MarkShiro/RoboDog-Zero/firmware/README.md

# Загрузка Arduino: пульт Pro Mini и Mega 2560

Все `.ino` открываются из одноимённой папки целиком: соседние `.h/.cpp` входят в сборку. Выберите **Arduino Pro or Pro Mini → ATmega328P (3.3V, 8 MHz)** для пульта и **Arduino Mega or Mega 2560 → ATmega2560** для робота. Проверенные зависимости: Arduino AVR Boards 1.8.6; Adafruit GFX 1.11.11; Adafruit ST7735 and ST7789 1.11.0; Adafruit BusIO 1.16.1; TMCStepper 0.7.3; Adafruit NeoPixel 1.15.2.

## 1. Пульт: безопасный тест

Загрузите [`RoboDogRemoteTest/RoboDogRemoteTest.ino`](RoboDogRemoteTest/RoboDogRemoteTest.ino). Перед загрузкой снимите джампер X2, если HC-05 подключён к D0/D1 и мешает загрузчику. Скетч проверяет дисплей ST7735 1,77″, восемь кнопок, напряжение батареи самого пульта через A6 и счётчик входящих строк Bluetooth. **Он не передаёт движущих команд.**

Кнопки: D4 вперёд, D5 назад, D6 влево, D7 вправо, D12 меню, A0 вверх, A1 вниз, A2 подтверждение. Цвет соответствующей кнопки должен меняться при нажатии. Число `LOCAL` зависит от фактического делителя батареи пульта и VREF 3,3 В; проверьте мультиметром. Если экран пуст, сначала проверьте питание/подсветку и CS10/DC9/RESET2, затем тип вкладки ST7735 в `initR`.

## 2. Пульт: основная прошивка

Загрузите [`RoboDogRemoteFinal/RoboDogRemoteFinal.ino`](RoboDogRemoteFinal/RoboDogRemoteFinal.ino), верните джампер X2 после завершения прошивки. Экран показывает напряжение робота из телеметрии Mega и примерный процент 8S LiFePO4. Цвет: 0–29% красный, 30–59% жёлтый, 60–99% зелёный, 100% синий. Сейчас 0% привязан к 24,0 В, 100% к 26,6 В в `battery.h`: это **шкала напряжения**, не измерение оставшейся ёмкости. Под нагрузкой показание может проседать. Батарея самого пульта измеряется отдельно и не подменяет напряжение робота.

Прошивка посылает кадры `C` 20 раз/с через HC-05 38400 бод и ждёт телеметрию `T`. При открытом меню кнопки движения игнорируются. Долгое нажатие/пункт «лечь» и команда отключения двигателей действуют только на уже разрешённую Mega; пульт не выполняет ARM. Если связи нет, на дисплее нет достоверного процента робота. Нельзя обходить этот признак подстановкой постоянного числа.

## 3. Mega: отдельный тест карты моторов

Актуальный порядок — [общая пусконаладка](../docs/commissioning.md) и [проверка концевиков любого порядка и NO/NC](../docs/limit-switches.md). Датчики проверяйте командой `STATUS` **до** `SCAN`: строка `raw` показывает HIGH как 1, строка `pressed` использует настроенную полярность каждого физического входа.

Загрузите [`RoboDogMotorMap/RoboDogMotorMap.ino`](RoboDogMotorMap/RoboDogMotorMap.ino) и пройдите [порядок пусконаладки](../docs/commissioning.md). Монитор USB 115200, окончание строки `Newline`. Поддержите корпус и каждую ногу; сначала проверьте физическое отключение питания двигателей. Последовательность `SCAN` → `J1` → `ARM` → `J +50` двигает **один** канал не более чем на 50 микрошагов. `J -50` — обратное направление, `!` — немедленная остановка, `OFF` — выключение. `SCAN` должен увидеть все восемь TMC2209. После каждого jog нужно повторять `ARM`. Запишите измеренные канал/ногу/сустав/направление/концевик в [таблицу](../docs/orange-pi/Mega-calibration-worksheet.csv). Тестовые 600 мА RMS заданы через UART при внешнем Rsense 0,11 Ω и нужны только для поддержанных ног, не для удержания всей массы.

## 4. Mega: основная прошивка

Создавайте `calibration.h` из измеренного локального JSON с помощью [генератора](../tools/generate_calibration.py): он проверяет уникальность входов и суставов и позволяет сначала проверить логические состояния датчиков с заблокированным ARM. Действия `--unlock` и `--enable-trot` разделены.

Загрузите [`RoboDogMegaFinal/RoboDogMegaFinal.ino`](RoboDogMegaFinal/RoboDogMegaFinal.ino), затем следуйте её [подробной инструкции](RoboDogMegaFinal/README.md). В стандартной сборке поиск нуля идёт по **восьми концевикам**. Значения калибровки намеренно пустые, `ROBOT_CALIBRATED=false`, опытная рысь выключена. После заполнения J1–J8 и проверки пределов, питания, аппаратного аварийного разрыва и D41 разрешите измеренную конфигурацию. Команда `ARM HOME` требует непрерывного нейтрального управления от Orange Pi; открыть USB-монитор и написать её без канала пульта недостаточно. Временная стендовая конфигурация `ARM ZERO` без датчиков — отдельный переключатель в `calibration.h`, описанный в инструкции; для итогового комплекта оставить 0.

На всех этапах сверяйте физическую разводку с электросхемой конкретной сборки. Передаточное число в прошивке — **12:1**. Диапазон положения ноги 30–40° относительно горизонта не задаёт автоматически электрические пределы каждого двигателя.
