MarkShiro/RoboDog-Zero/firmware/RoboDogMegaFinal/README.md

# RoboDogMegaFinal — прошивка, калибруемая под каждый экземпляр

Плата: Arduino Mega 2560, ATmega2560, 16 МГц.

**Заводская конфигурация разрешает проверку запуска и связи, но блокирует движение.** Для комплекта с восемью концевиками используется `ROBODOG_STARTUP_ZERO_MODE=0`; команда `ARM HOME` запускает ограниченный поиск нулей после калибровки. Соответствие J1–J8, направления и положения датчиков измеряются на каждом экземпляре и заносятся в локальный профиль. Отдельный стендовый режим временного нуля без концевиков описан ниже.

Стендовый скетч [`RoboDogMotorMap`](../RoboDogMotorMap/) загружается отдельно; его файлы не смешивают с этой папкой.

## 1. Что реализовано

- Нет автоматического включения моторного питания и поиска нулей в `setup()`.
- После STOP, тайм-аута и ошибки нет автоматического повторного включения.
- Разрешение работы отдельной командой; требуются проверенная карта/знаки/пределы, свежий нейтральный поток управления, исправные напряжения, аппаратный разрыв силовой цепи и все восемь драйверов. Для режима с концевиками дополнительно требуется проверенный D41.
- Конфигурация TMC2209 через две UART-шины, внешние R110, 16 микрошагов, начальные 600 мА RMS, SpreadCycle. Проверяется связь и ряд регистров.
- Прекращение импульсов и снятие EN при зависании основного цикла примерно на 250 мс по таймеру; срок ограничен также остатком актуальности команды. Это программная защита, её реальные задержки нужно измерить.
- Независимый watchdog AVR на 4 с для перезапуска зависшей программы. Сброс Mega может снять самоудержание всего робота — это свойство схемы, а не штатное завершение Linux.
- Парсер с CRC, ограничением длины, строгими диапазонами и отбраковкой хвоста переполненной строки.
- Повторный/старый `seq` в пределах активного сеанса не продлевает время команды. Корректный STOP обрабатывается даже из старого пакета.
- В основной конфигурации выполняется ограниченный поиск нулей по концевикам. Для стендовых испытаний доступен отдельный режим временного нуля без движения.
- Программные пределы суставов после поиска нулей, включая запрет следующего импульса за границу в обработчике таймера. Потерянные шаги между повторными поисками нулей не обнаруживаются.
- Поза лёжа сохраняется после короткого сигнала пульта; нейтральное управление не заставляет автоматически вернуться в стойку.
- Экспериментальная диагональная походка отдельно заблокирована. Она задаёт синусоидальные углы суставов, не решает обратную кинематику стоп и не стабилизирует корпус.
- Телеметрия `T` совместима с подготовленным пультом.
- Дополнительный кадр `I,roll,pitch,temp,flags` с CRC передаёт углы MPU6050 для экрана Orange Pi примерно 5 раз/с. Углы вычисляются по акселерометру и при рывках ненадёжны.
- Кадр `K` игнорируется и не меняет время снятия питания. Автоматическое снятие самоудержания по умолчанию выключено до испытания завершения Orange Pi.

## 2. Какие файлы менять

| Файл | Назначение |
|---|---|
| `RoboDogMegaFinal.ino` | Главный цикл, состояния, команды USB, включение и отключение |
| `calibration.h` | Карта осей, углы, пределы и разрешающие проверки |
| `config.h` | Пины, напряжения, ток, тайм-ауты и частота шагового таймера |
| `steppers.cpp/.h` | TMC2209, STEP/DIR, контроль разрешения и границ |
| `motion.cpp/.h` | Поиск нулей, позы, экспериментальная походка |
| `link.cpp/.h`, `wire_protocol.h` | Формат UART, CRC, seq, ARM, телеметрия |
| `power.cpp/.h` | Питание, АЦП, тормозные ключи, вентилятор |
| `imu.cpp/.h` | Чтение MPU6050; стабилизация не реализована |
| `leds.cpp/.h` | Лента; обновление запрещено при разрешённых драйверах, чтобы не задерживать STEP |

## 3. Электрическая привязка

| Канал | UART TMC | Адрес | STEP | DIR | Вход по умолчанию |
|---|---|---:|---:|---:|---:|
| J1 | Serial1 | 0 | 22 | 30 | 42 |
| J2 | Serial1 | 1 | 23 | 31 | 43 |
| J3 | Serial1 | 2 | 24 | 32 | 44 |
| J4 | Serial1 | 3 | 25 | 33 | 45 |
| J5 | Serial2 | 0 | 26 | 34 | 46 |
| J6 | Serial2 | 1 | 27 | 35 | 47 |
| J7 | Serial2 | 2 | 28 | 36 | 48 |
| J8 | Serial2 | 3 | 29 | 37 | 49 |

Пин в последнем столбце — исходное соответствие в шаблоне конфигурации. Измеренная карта задаётся массивом `LIMIT_INPUT_FOR_J` через профиль; на каждом канале можно отдельно выбрать активный LOW или HIGH. `STATUS` показывает состояния в **порядке J1–J8**, а не по порядку пинов. При поиске нуля срабатывание датчика другой оси вызывает остановку. См. [пошаговую проверку](../../docs/limit-switches.md).

Serial1: TX18/RX19; Serial2: TX16/RX17. На каждой шине адреса 0–3 задаются проводкой MS1/MS2. Общий EN — D38, активный LOW. Моторное питание — D39. Самоудержание — D7. Запрос работы — D3, активный LOW. Отдельный сигнальный контакт аварийной кнопки подключается к D41, активный LOW; его работу проверяют перед разблокировкой. Аппаратная цепь разрыва моторного питания должна работать независимо от программы.

Названия `V20F/V20R` и `BRAKE_F/BRAKE_R` унаследованы из исходника. В этой сборке это электрические шины A/B, а не подтверждённые передние/задние ноги. Фактически платы отвечают за правую/левую стороны; какую из сторон обслуживает каждая UART-шина, определить измерением.

АЦП: A0 батарея, A1 и A2 моторные шины. Расчёт рассчитан на делитель 100 кОм/20 кОм и VREF 5000 мВ. Перед разрешением движения проверить подключение всех трёх делителей и откалибровать VREF по измерению. Диапазон разрешения батареи: выше 24 В и не выше 29,5 В; моторных шин: 17–24,5 В. Это предварительные пороги проекта, а не характеристики BMS или гарантия допустимого выброса напряжения. Программное торможение не заменяет проверку силовой части осциллографом.

## 4. Ток под имеющиеся моторы

В этой сборке установлено **600 мА RMS** для начальных испытаний с поддержанными ногами. Это не расчёт достаточного тока для удержания массы робота. При таком токе робот может не удерживать себя: первые проверки делать на опоре.

`rms_current(600, 1.0)` задаёт ток через UART. `I_scale_analog(false)` отключает аналоговое масштабирование VREF; `internal_Rsense(false)` выбирает внешние измерительные резисторы. Нужно подтвердить R110 на ваших модулях. Положение потенциометра не заменяет программную настройку в этом режиме. Отношение синусоидального пикового тока к RMS — примерно √2: 600 мА RMS соответствуют около 0,85 А пикового тока. См. [официальный datasheet TMC2209](https://www.analog.com/media/en/technical-documentation/data-sheets/TMC2209_datasheet_rev1.09.pdf).

Не ставить автоматически `1500` лишь потому, что на моторе указано 1,5 А на фазу: необходимо согласовать определение номинала двигателя, режим возбуждения, нагрев, охлаждение модулей и нагрузку. Следующие значения подбираются ступенями после стендовых измерений тока/нагрева и пропусков шагов. Удержание временно равно рабочему току; прежние 35% нельзя считать достаточными для стоящего робота без испытания.

## 5. Загрузка и первая проверка

1. Физически отключить силовое питание моторов. Поддержать корпус и ноги.
2. Не подключать Orange Pi к схеме самоудержания во время первых загрузок Mega. USB/DTR может сбросить Mega и погасить общую систему.
3. Открыть **всю папку** `RoboDogMegaFinal`, затем файл `RoboDogMegaFinal.ino` в Arduino IDE.
4. Выбрать Arduino Mega or Mega 2560 / ATmega2560 и фактический порт.
5. Установить библиотеки TMCStepper 0.7.3 и Adafruit NeoPixel 1.15.2. Wire входит в пакет Arduino AVR Boards. Проверенная версия пакета плат — 1.8.6.
6. Выполнить компиляцию и загрузку. Соседние `.h/.cpp` должны остаться в одной папке со скетчем.
7. Открыть монитор USB Serial: **115200, Newline**. Ожидается сообщение `DISARMED` и блокировка калибровки.
8. Отправить `STATUS`. Проверить `armed=0`, `calibrated=0`, запрет EN и отсутствие моторного питания.
9. Команда `ARM HOME` сейчас должна ответить `ARM REFUSED: fill and verify calibration.h`. Это ожидаемая проверка блокировки, а не ошибка сборки.
10. Проверить Serial3 в режиме только чтения: **38400, 8N1**, корректные `T` примерно 10 Гц. USB Serial0 и Serial3 — разные интерфейсы.

Если D3 разомкнут, прошивка перейдёт в SHUTDOWN и будет передавать `X`; в этой сборке D7 останется активен. Для проверки обычного режима нужен реально замкнутый штатный переключатель запроса работы. Не замыкать неизвестные контакты наугад.

Проверить аппаратную подтяжку EN к запрещённому уровню при сбросе/загрузчике: программа не управляет выводом до начала выполнения. Не подключать/отключать обмотки при включённом драйвере.

## 6. Получение карты моторов

Для определения каналов используйте отдельную прошивку [`RoboDogMotorMap`](../RoboDogMotorMap/) по [порядку пусконаладки](../../docs/commissioning.md). Она делает короткие ограниченные перемещения одного канала через USB и не запускает походку.

Для каждого J1–J8 записать:

1. Фактическую ногу: передняя левая / передняя правая / задняя левая / задняя правая.
2. Какой сустав обслуживается: проксимальный или дистальный.
3. Как двигается выбранный измеряемый угол при `J +50`.
4. Какой физический концевик меняет соответствующий вход D42–D49 и где он расположен.
5. В каком электрическом направлении находится этот концевик.
6. Фактический угол при его срабатывании и допустимый диапазон без удара, натяжения проводов и контакта с корпусом.
7. Углы стойки и положения лёжа относительно точки срабатывания.
8. Максимальный допустимый путь поиска концевика из начальной механической позы.

Шаблон: `docs/orange-pi/Mega-calibration-worksheet.csv`. Смена прошивки и отключение моторов делают прежние шаговые позиции недостоверными. Для промеров применяются механические метки и измерения; число отправленных шагов само по себе не доказывает реальный угол при пропуске шагов.

## 7. Создание calibration.h по измеренному профилю

Из корня проекта создайте `commissioning/robot.json` командой `python tools/generate_calibration.py --init commissioning/robot.json`. Восемь строк содержат измеренные моторы, углы, `limit_pin` и `limit_pressed_level`. Команда `python tools/generate_calibration.py --input commissioning/robot.json` создаёт `calibration.h` с **заблокированным ARM**; так можно проверить, что `STATUS` даёт по одному правильному логическому биту при ручном нажатии каждого датчика. Лишь после всех физических проверок поставьте `verified.*=true` и повторите генерацию с `--unlock`. Опытная походка включается ещё отдельным `--enable-trot` после проверки на опоре. [Полный порядок](../../docs/commissioning.md) и [настройка концевиков](../../docs/limit-switches.md) описаны отдельно.

Номера ног: 0 передняя левая, 1 передняя правая, 2 задняя левая, 3 задняя правая. Сустав: 0 проксимальный, 1 дистальный. Строка массива — электрический J, анатомический порядок произвольный.

| Поле | Значение |
|---|---|
| `leg`, `joint` | Уникальное соответствие одной из восьми осей |
| `angleSign` | +1: электрический положительный шаг увеличивает измеряемый угол; иначе −1 |
| `homeDir` | Электрическое направление к концевику, +1 или −1 |
| `homeAngle` | Угол непосредственно в точке срабатывания концевика |
| `minAngle`, `maxAngle` | Рабочие механические пределы по сторону отхода от концевика |
| `standAngle`, `sitAngle` | Измеренные позы |
| `amplitude` | Начальная амплитуда экспериментальной траектории; не более 500 сотых градуса = 5° |
| `maxHomeSteps` | Предел пути поиска/отхода: 200–12800 импульсов, измерить по механике |

Углы задаются в **сотых долях градуса**, например 3500 означает 35°. Но нельзя просто поставить всем суставам 3000–4000: сначала определить, как угол каждого двигателя связан с углом сегмента относительно горизонта. В механизме с замкнутой кинематической цепью одного редуктора для такого перевода может быть недостаточно; тогда до разрешения походки требуется модель кинематики.

Поиск выполняется последовательно J1…J8. Отход от каждого сработавшего концевика — 200 импульсов, около 1,875° выходного вала при 12:1. Отход должен оказаться в измеренных рабочих пределах. Каждый этап ограничен по времени и числу отправленных шагов. 1° выходного вала — около 106,67 STEP, но это не обязательно 1° сегмента ноги относительно горизонта.

Сначала оставить `ENABLE_EXPERIMENTAL_TROT=false`. После проверки всей таблицы и схемы подтвердить `ROBOT_CALIBRATED`, `HARDWARE_MOTOR_CUT_VERIFIED`, `ESTOP_SIGNAL_VERIFIED`, `RAIL_SENSING_VERIFIED`, `DRIVER_RSENSE_VERIFIED`. Проставление флагов без измерений не является калибровкой. Валидатор проверит уникальность осей, знаки, границы, отход от концевика и принадлежность каждой платы одной стороне. Аппаратная кнопка должна также физически разрывать моторную цепь независимо от D41.

Первая разрешённая процедура `ARM HOME` ищет восемь нулей и переводит робота в калиброванную стойку. Корпус и ноги должны быть поддержаны. Не начинать из произвольного положения возле механического упора.

### Временный режим без концевиков для отдельной стендовой сборки

В `calibration.h` сменить `#define ROBODOG_STARTUP_ZERO_MODE 0` на `1`. Тогда команда USB называется `ARM ZERO`: она включает драйверы и обнуляет счётчики STEP **без движения**. Для этого режима `homeDir` и `maxHomeSteps` не используются; `homeAngle=0`; `minAngle<0<maxAngle` внутри измеренного диапазона ±40°. Каждый раз до ARM вернуть валы в помеченную стартовую позу. После пропуска шага или отключения драйверов ноль потерян. Этот режим не заменяет основную сборку с концевиками. Флаги калибровки и аппаратной защиты всё равно нельзя включать без проверок.

## 8. Команды управления

USB Serial0, 115200, строки с переводом строки:

| Команда | Действие |
|---|---|
| `STATUS` | Состояние, калибровка, разрешение, свежесть, напряжения, шаговые координаты |
| `ARM HOME` | После всех проверок: включить драйверы, найти нули по концевикам и перейти в стойку; нужен непрерывный нейтральный `C` на Serial3 |
| `ARM ZERO` | Только в отдельной сборке `ROBODOG_STARTUP_ZERO_MODE=1`: принять текущую позу за относительный ноль без движения |
| `STAND` | Переход в откалиброванную стойку, если уже разрешены моторы и найден ноль |
| `OFF` | Отмена движения, запрет драйверов и моторного питания, потеря нулей |
| `!` | Немедленная обработка остановки без ожидания конца USB-строки |
| `SHUTDOWN` | Остановить моторы и запрашивать выключение Pi; автоматическое снятие D7 по умолчанию запрещено |

USB — диагностический канал. Его открытие может вызвать аппаратный сброс независимо от того, какую команду хотели отправить. Во время питания робота от общей батареи нужен заранее проверенный способ отладки без DTR-сброса; не обходить цепи питания случайной перемычкой.

Serial3 сохраняет тела `C,seq,buttonsHex,remoteMv,speed,mode` и `T,seq,state,vbusMv,flagsHex`. Обрамление `*CRC\n`, CRC-8/0x07. `C` должен обновляться, рекомендуемый темп — 20 Гц. Предел актуальности — 500 мс. Счётчик 16 бит; переход 65535 → 0 корректен. Противоположные направления взаимно отменяются. Поле `mode` зарезервировано и не включает автономность.

Новая команда Pi → Mega: **`A,seq*CRC\n`**, где `seq` совпадает с последним принятым **нейтральным** `C` (`buttons=0`). Один и тот же `A` подряд повторно не принимается. Её отправляет интерфейс Orange Pi после явной локальной команды `--arm`, либо оператор использует USB `ARM HOME`. Обычная ретрансляция старого пульта **не включает моторы**.

Во время HOME нейтральный поток C должен продолжаться; направляющая команда или STOP отменяет процедуру. После отключения драйверов требуется новое разрешение и новый поиск нулей.

Нейтральная команда во время ходьбы останавливает траекторию в текущих командных координатах с сохранением питания. Это не эквивалент устойчивой позы на земле. При потере связи снимаются разрешение и моторное питание; корпус может опуститься. Физическая опора обязательна во время испытаний.

Состояния T остаются 0 BOOT/HOME, 1 IDLE, 2 RUN, 3 WARN, 4 ESTOP/зафиксированная ошибка, 5 SHUTDOWN. IDLE само по себе не означает готовности ходить: смотреть флаги питания, нулей и диагностику. Флаг DRIVERS_OK означает последнюю успешную проверку; один драйвер опрашивается раз в 250 мс, полный обход примерно 2 с плюс время UART. Это не мгновенная аппаратная защита от неисправности.

## 9. Походка и ограничения

`ENABLE_EXPERIMENTAL_TROT` по умолчанию false. При включении после калибровки используются диагональные фазы FL/RR и FR/RL, периоды 6,0–3,5 с и ограниченные амплитуды в таблице. Команда чистого поворота формирует разные задания бортов; её физическое направление нужно подтвердить на стенде.

Наличие диагональных фаз ещё не означает пригодную для робота рысь. В этой сборке нет траекторий стоп через обратную кинематику, датчиков контакта, компенсации пропусков шагов, активной стабилизации IMU и проверенной устойчивости. После измерения геометрии движения могут потребовать изменения модели, а не только чисел амплитуды.

Текущие ограничения: 1200 микрошагов/с, ускорение 1600 микрошагов/с², поиск 200 микрошагов/с, таймер 8 кГц. Импульсы, DIR setup, загрузку процессора и одновременную работу восьми осей проверить анализатором. Автоматические тесты не моделируют длительность инструкций AVR, UART на реальных проводах, силовые выбросы, дребезг и отскок механики.

## 10. Завершение работы

Отключение D3 или корректно измеренное напряжение батареи ≤24 В переводит в SHUTDOWN. Mega отправляет `X` каждые 2 с. По умолчанию D7 сохраняет самоудержание питания: автоматическое снятие требует измеренного времени завершения установленной ОС и отдельной проверки силовой схемы. В этом режиме питание продолжает расходоваться; завершите Linux и снимите общее питание вручную по проверенной процедуре.

Флаг `AUTOMATIC_POWER_RELEASE=true` включает только фиксированную задержку 60+8=68 с от запроса. Это резервный механизм, а не подтверждение завершения ОС; использовать только после отдельного испытания и принятия такого поведения. Пакет K не ускоряет отключение. Для надёжного согласования в дальнейшем нужен отдельный проверенный протокол/сигнал готовности и изменения на обеих сторонах.

## 11. Проверки, выполненные на компьютере

Сборка Arduino AVR выполнена. Проверены исходники реального парсера, главного цикла, движения и генератора шагов с подменой аппаратных интерфейсов:

- границы полей, повреждённые/длинные строки, CRC, seq wrap и повтор;
- ARM только отдельным запросом, отмена ARM направляющей командой;
- старый корректный STOP, отсутствие действия K;
- отсутствие STEP/изменения позиции при запрещённых драйверах;
- отключение при истечении таймерного разрешения и пересечении программной границы;
- блокировка загрузочной конфигурации при запросе ARM;
- потеря связи не маскируется первым пакетом после восстановления;
- относительный ноль сбрасывается при отключении; альтернативный поиск концевиков ограничен временем и путём;
- поза лёжа не сбрасывается коротким нейтральным пакетом;
- нажатый вход концевика отменяет позиционное управление, если он установлен;
- отсутствует автоматическое снятие питания по старому ACK.

Компьютерные тесты проверяют программные условия, но не заменяют испытаний на конкретной плате, проверки проводки и измерений под нагрузкой.
