MarkShiro/RoboDog-Zero/docs/orange-pi/Mega-calibration-worksheet.csv

channel | uart | address | step_pin | dir_pin | limit_pin | physical_side | leg | joint | positive_jog_angle_direction | home_direction | home_angle_deg | min_angle_deg | max_angle_deg | stand_angle_deg | sit_angle_deg | max_home_steps | limit_verified | notes
J1 | Serial1 | 0 | 22 | 30 | 42 | UNKNOWN | UNKNOWN | UNKNOWN | UNKNOWN | UNKNOWN | UNKNOWN | UNKNOWN | UNKNOWN | UNKNOWN | UNKNOWN | UNKNOWN | NO
J2 | Serial1 | 1 | 23 | 31 | 43 | UNKNOWN | UNKNOWN | UNKNOWN | UNKNOWN | UNKNOWN | UNKNOWN | UNKNOWN | UNKNOWN | UNKNOWN | UNKNOWN | UNKNOWN | NO
J3 | Serial1 | 2 | 24 | 32 | 44 | UNKNOWN | UNKNOWN | UNKNOWN | UNKNOWN | UNKNOWN | UNKNOWN | UNKNOWN | UNKNOWN | UNKNOWN | UNKNOWN | UNKNOWN | NO
J4 | Serial1 | 3 | 25 | 33 | 45 | UNKNOWN | UNKNOWN | UNKNOWN | UNKNOWN | UNKNOWN | UNKNOWN | UNKNOWN | UNKNOWN | UNKNOWN | UNKNOWN | UNKNOWN | NO
J5 | Serial2 | 0 | 26 | 34 | 46 | UNKNOWN | UNKNOWN | UNKNOWN | UNKNOWN | UNKNOWN | UNKNOWN | UNKNOWN | UNKNOWN | UNKNOWN | UNKNOWN | UNKNOWN | NO
J6 | Serial2 | 1 | 27 | 35 | 47 | UNKNOWN | UNKNOWN | UNKNOWN | UNKNOWN | UNKNOWN | UNKNOWN | UNKNOWN | UNKNOWN | UNKNOWN | UNKNOWN | UNKNOWN | NO
J7 | Serial2 | 2 | 28 | 36 | 48 | UNKNOWN | UNKNOWN | UNKNOWN | UNKNOWN | UNKNOWN | UNKNOWN | UNKNOWN | UNKNOWN | UNKNOWN | UNKNOWN | UNKNOWN | NO
J8 | Serial2 | 3 | 29 | 37 | 49 | UNKNOWN | UNKNOWN | UNKNOWN | UNKNOWN | UNKNOWN | UNKNOWN | UNKNOWN | UNKNOWN | UNKNOWN | UNKNOWN | UNKNOWN | NO
