MarkShiro/RoboDog-Zero/docs/commissioning.md

# Пусконаладка RoboDog Zero от первого питания до движения

Это порядок для полного комплекта: восемь двигателей через TMC2209 v2.0, **восемь концевиков**, Mega 2560, пульт Pro Mini, Orange Pi AIpro 8T с openEuler, TFT 2,4″ 240×320 и Coin D6 через USB–UART. Исходники выполняют связь, телеметрию, экран, поиск нулей, позы и ограниченную диагональную походку. Физические значения нельзя скопировать с другого робота: калибровка создаётся по замерам при сборке. Диапазон 30–40° для положения ноги относительно горизонта не задаёт автоматически рабочий угол каждого вала.

## 0. Подготовьте механическую и силовую часть

Поставьте корпус на опору, чтобы ни одна нога не несла массу при первом движении. Проверьте полярность 8S LiFePO4, предохранитель, общий GND логики, отдельные силовые шины, разъёмы всех обмоток, наличие вентиляторов и аппаратную аварийную кнопку. На обеих платах TMC2209 прочитайте маркировку внешнего `Rsense` (в коде 0,11 Ω, R110). При отличии измените `RSENSE` в стендовом скетче и `TMC_RSENSE` в итоговом `config.h` **до подачи моторного питания**. Измерьте выход 5 В Mega, напряжения A0/A1/A2 и реальные делители; скорректируйте `VREF_MV` и делитель только по замеру. Нельзя проверять двигатель, пока неизвестные шины питания выходят за диапазон платы.

Ток `600 mA RMS` в обеих Mega-прошивках — начальный режим для идентификации и поддержанной конструкции, а не обещание удержания веса. В режиме UART `rms_current()` потенциометр Vref не является основным заданием тока. Фактический ток проверяют по настройкам TMC и нагреву мотора/драйвера; не измеряйте фазный ток как ток батареи. См. [инструкцию Mega](../firmware/RoboDogMegaFinal/README.md#4-ток-под-имеющиеся-моторы) и [официальный datasheet TMC2209](https://www.analog.com/media/en/technical-documentation/data-sheets/TMC2209_datasheet_rev1.09.pdf).

## 1. Отдельно проверьте пульт

Сначала прошейте [`RoboDogRemoteTest`](../firmware/RoboDogRemoteTest/), проверьте дисплей, кнопки, питание и входящие строки. Затем [`RoboDogRemoteFinal`](../firmware/RoboDogRemoteFinal/) и приблизительный процент батареи рядом с напряжением. Пульт не должен неожиданно передавать команды движения при отпускании кнопок. Для BLE не подходит: связь этого проекта — Bluetooth Classic SPP через HC-05 на 38400 бод. Подробности в [инструкции прошивок](../firmware/README.md).

## 2. Составьте карту концевиков без питания моторов

Прошейте [`RoboDogMotorMap`](../firmware/RoboDogMotorMap/) и выполните `STATUS` через USB на 115200 бод. Для каждого физического датчика запишите отпущенное/нажатое raw-состояние и фактический вход D42–D49. Перед проверкой двигателей настройте `LIMIT_ACTIVE_LOW` в стендовом скетче по NO/NC. Пошаговая таблица, диагностика перепутанных проводов и пример переназначения находятся в [отдельной инструкции](limit-switches.md). Состояние «все отпущены» после выбранной полярности — `00000000`.

## 3. Найдите каждый мотор и направление

Проверьте работу физического разрыва питания моторов аварийной кнопкой независимо от Mega, затем напряжения A0/A1/A2 и связь всех восьми TMC по `SCAN`. Отпустите концевики, выберите `J1`, отправьте `ARM`, затем одну короткую `J +50` (при необходимости меньшую) и запишите, какой сустав двинулся и как изменился **измеряемый угол**. Одна команда двигает один канал и расходует ограниченный бюджет импульсов; повторный `ARM` нужен для каждого короткого jog. Повторите J1…J8 и обратное направление в безопасном диапазоне. `!` немедленно снимает питание моторов. Никакой jog нельзя делать, когда корпус опирается на ноги.

Для каждой оси запишите: ногу FL/FR/RL/RR; проксимальный или дистальный сустав; знак угла при `J +50`; направление **к** своему концевику; угол непосредственно при контакте; обе мягкие границы с запасом от механического упора; угол стойки и положения лёжа; безопасный максимальный путь поиска. Обе платы по четыре драйвера должны соответствовать разным сторонам (какая сторона J1–J4, определяется измерением). При 1/16 и 12:1 один градус выходного вала — около 106,67 STEP; реальный угол ноги при рычажной передаче может быть иным.

## 4. Сформируйте и проверьте итоговую калибровку

```bash
python tools/generate_calibration.py --init commissioning/robot.json
# Заполните JSON по измерениям. Поля verified пока оставьте false.
python tools/generate_calibration.py --input commissioning/robot.json
```

Генератор переведёт углы из градусов в сотые градуса, проверит восемь уникальных анатомических осей и восемь уникальных входов D42–D49, полярности, платы по сторонам, мягкие границы и программный отход на 200 STEP. Если условия нарушены, он сообщит конкретную строку J и не запишет прошивку. Поля в `verified`:

| Поле | Что оператор реально проверяет |
|---|---|
| `hardware_motor_cut` | Аварийная кнопка аппаратно разрывает силовую цепь даже без программы |
| `estop_signal` | Отдельный контакт D41 меняет состояние и Mega обнаруживает нажатие |
| `rail_sensing` | A0/A1/A2 и делители сверены с мультиметром в допустимом диапазоне |
| `driver_rsense` | Все восемь Rsense сверены с кодом и связь UART проверена |
| `limits_press_release` | Каждый датчик меняет ровно свой логический бит и возвращается |
| `motor_direction` | J1–J8, знаки углов и направление к контакту измерены |
| `mechanical_bounds` | Стойка, лёжка, рабочие границы и запас от упоров измерены |
| `manual_home_path` | При снятом питании вручную проверен свободный путь к датчику и назад |

Прошейте Mega созданным `calibration.h`, пока **ARM заблокирован**. С отключёнными моторами команда `STATUS` должна показать `calibrated=0` и `limits J1..J8 (1=pressed): 00000000`. Ручное нажатие каждого датчика должно менять ровно один бит с соответствующим номером J — даже если вход физически «чужой». Это позволяет обнаружить ошибку профиля до движения. Если вход не D42–D49 или два датчика используют один вход, исправьте проводку; программно это не компенсируется.

Когда все восемь пунктов `verified` подтверждены физически, установите для них `true`, затем:

```bash
python tools/generate_calibration.py --input commissioning/robot.json --unlock
```

Генератор установит пять разрешающих флагов итоговой Mega-прошивки, сохранив `ENABLE_EXPERIMENTAL_TROT=false`. Пересоберите и загрузите скетч. Один только `calibrated=1` подтверждает целостность конфигурации и отмеченные оператором проверки; он не доказывает устойчивость робота. Файл `commissioning/robot.json` не попадает в Git; сохраните копию вместе с журналом измерений своего экземпляра.

## 5. Запустите Orange Pi и вертикальный экран

На образе `opiaipro_openEuler22.03_desktop_aarch64_20240604` выполните [инструкцию Orange Pi](../orange_pi/README.md): проверьте версии ОС, установите Python-окружение, запустите тесты и три страницы PNG. Сохраните адреса интерфейсов в локальном `orange_pi/config.json`. TFT принимает отдельные SPI CS для дисплея и касания; выберите фактический контроллер и GPIO offsets, проверьте цвета и портретный поворот. В основном поле должно быть **ZE** над **RO**, а три кнопки — внизу на короткой стороне дисплея. Настройте четыре угла касания; касание меняет только страницу.

После этого проверьте Mega Serial3 38400, HC-05 SPP 38400 и Coin D6 на отдельном USB–UART 230400. Вкладки IMU и LiDAR должны различать живые и отсутствующие данные; деморежим явно подписан. Не принимайте подключение `/dev/ttyUSB*` за доказательство корректных пакетов лидара: переместите измеренный предмет и сравните дальность и направление. Включение приложения Orange Pi само по себе не отправляет ARM.

## 6. Первый HOME, стойка и ограниченное движение

Верните все ноги в проверенные вручную стартовые положения, все концевики отпустите. С корпусом на опоре, доступной аварийной кнопкой и нейтральным свежим пультом отправьте `ARM HOME` по USB Mega либо явный запрос `--arm` локально на Orange Pi. Mega последовательно ищет восемь датчиков, отходит от каждого на 200 STEP и задаёт измеренную стойку. Наблюдайте J1…J8, направления, датчики, напряжение и температуру драйверов. При неожиданном движении нажмите аппаратную кнопку; перед повтором выясните причину и заново проверьте `STATUS`.

Сначала проверьте `STAND`/положение лёжа на опоре и поведение при потере связи/STOP. Для опытной диагональной походки снимите опору лишь после низкоскоростного испытания с удержанием корпуса и измерения нужного тока. Подбирайте `trot_amplitude_deg` по каждой оси в пределах 0–5°, а не копируйте 30–40° положения ноги. Когда траектория на опоре проверена, создайте прошивку с `--unlock --enable-trot`, загрузите и начните с минимальной скорости и ограниченной дистанции. Это программная диагональная траектория по суставам; активной стабилизации IMU, обратной кинематики стоп и контроля потери шагов в ней нет. Если конструкция их требует для безопасной ходьбы, настройкой числа в JSON это не исправить.

## Проверка перед каждым запуском

Проверить питание и механические крепления; вручную нажать/отпустить каждый концевик с выключенными моторами и посмотреть `STATUS`; испытать аппаратную аварийную кнопку; убедиться, что датчики отпущены, пульт нейтрален, робот поддержан до окончания HOME; следить за напряжением и нагревом. После любой перестановки моторов/датчиков повторить карту и сгенерировать калибровку заново.
