MarkShiro/RoboDog-Zero/firmware/RoboDogRemoteFinal/cyr_font.h

// =====================================================================
//  cyr_font.h — растровый шрифт 6 x 8 с кириллицей.
//
//  ЭТОТ ФАЙЛ МЕНЯТЬ НЕ НУЖНО. Это просто картинки букв, по шесть байт
//  на букву: каждый байт — столбец, каждый бит — точка сверху вниз.
//
//  Порядок: сначала ASCII с пробела до тильды, потом русские буквы
//  подряд от А до я. Функция отрисовки сама находит нужную по коду.
//
//  Русские строчные нарисованы формой заглавных: на сетке шесть на восемь
//  у строчной буквы остаётся четыре ряда высоты, и «т», «в», «г», «з»
//  перестают отличаться друг от друга. Поэтому что ни напиши — «Лечь»
//  или «ЛЕЧЬ» — на экране получится «ЛЕЧЬ», и это читается.
// =====================================================================
#pragma once
#include <Arduino.h>

#define FONT_W 6
#define FONT_H 8
#define FONT_ASCII_FIRST 32
#define FONT_ASCII_LAST  126
#define FONT_CYR_FIRST   0x410
#define FONT_CYR_LAST    0x44F
#define FONT_CYR_INDEX   95

const uint8_t FONT6x8[] PROGMEM = {
  0x00, 0x00, 0x00, 0x00, 0x00, 0x00,  //  
  0x00, 0x00, 0x5E, 0x5E, 0x00, 0x00,  // !
  0x00, 0x00, 0x0E, 0x06, 0x00, 0x00,  // "
  0x00, 0x78, 0x3E, 0x78, 0x3E, 0x00,  // #
  0x00, 0x4C, 0x5C, 0xFE, 0x74, 0x00,  // $
  0x23, 0x13, 0x08, 0x64, 0x62, 0x00,  // %: two dots and diagonal slash
  0x00, 0x7C, 0x5E, 0x72, 0x70, 0x00,  // &
  0x00, 0x00, 0x04, 0x06, 0x00, 0x00,  // '
  0x00, 0x00, 0x7C, 0xC6, 0x00, 0x00,  // (
  0x00, 0x00, 0xC6, 0x7C, 0x00, 0x00,  // )
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
  0x00, 0x7E, 0x7C, 0x7E, 0x7E, 0x00,  // Ш
  0x00, 0x7E, 0x7E, 0x40, 0xFE, 0x80,  // Щ
  0x00, 0x02, 0x7E, 0x58, 0x70, 0x00,  // Ъ
  0x00, 0x7E, 0x58, 0x70, 0x7E, 0x00,  // Ы
  0x00, 0x7E, 0x58, 0x58, 0x70, 0x00,  // Ь
  0x00, 0x42, 0x52, 0x5E, 0x3C, 0x00,  // Э
  0x00, 0x7E, 0x7C, 0x42, 0x7E, 0x00,  // Ю
  0x00, 0x4C, 0x3E, 0x12, 0x7E, 0x00,  // Я
  0x00, 0x70, 0x3E, 0x3E, 0x70, 0x00,  // а
  0x00, 0x7E, 0x5A, 0x5A, 0x72, 0x00,  // б
  0x00, 0x7E, 0x5A, 0x5A, 0x7C, 0x00,  // в
  0x00, 0x7E, 0x7E, 0x02, 0x02, 0x00,  // г
  0x00, 0xFE, 0x5E, 0x42, 0xFE, 0x80,  // д
  0x00, 0x7E, 0x5A, 0x4A, 0x4A, 0x00,  // е
  0x00, 0x76, 0x7C, 0x7E, 0x7E, 0x00,  // ж
  0x00, 0x42, 0x4A, 0x5A, 0x7C, 0x00,  // з
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
};
