MarkShiro/RoboDog-Zero/(commit log)

2026-09-28 Add RoboDog Arduino firmware, Orange Pi UI and bring-up guides
    [Mega-calibration-worksheet.csv]
2026-09-30 Finish portrait ZERO UI and universal limit-switch commissioning
